Misaka0x2730/RubyLink/README.md

# RubyLink
Hardware platform for Miyako-Link based on RP2040

Firmware: https://github.com/Misaka0x2730/Miyako-Link
