Misaka0x2730/RubyLink/revB/RubyLink_revB.kicad_pcb

## KiCad design revB/RubyLink_revB.kicad_pcb (2022-08-15)

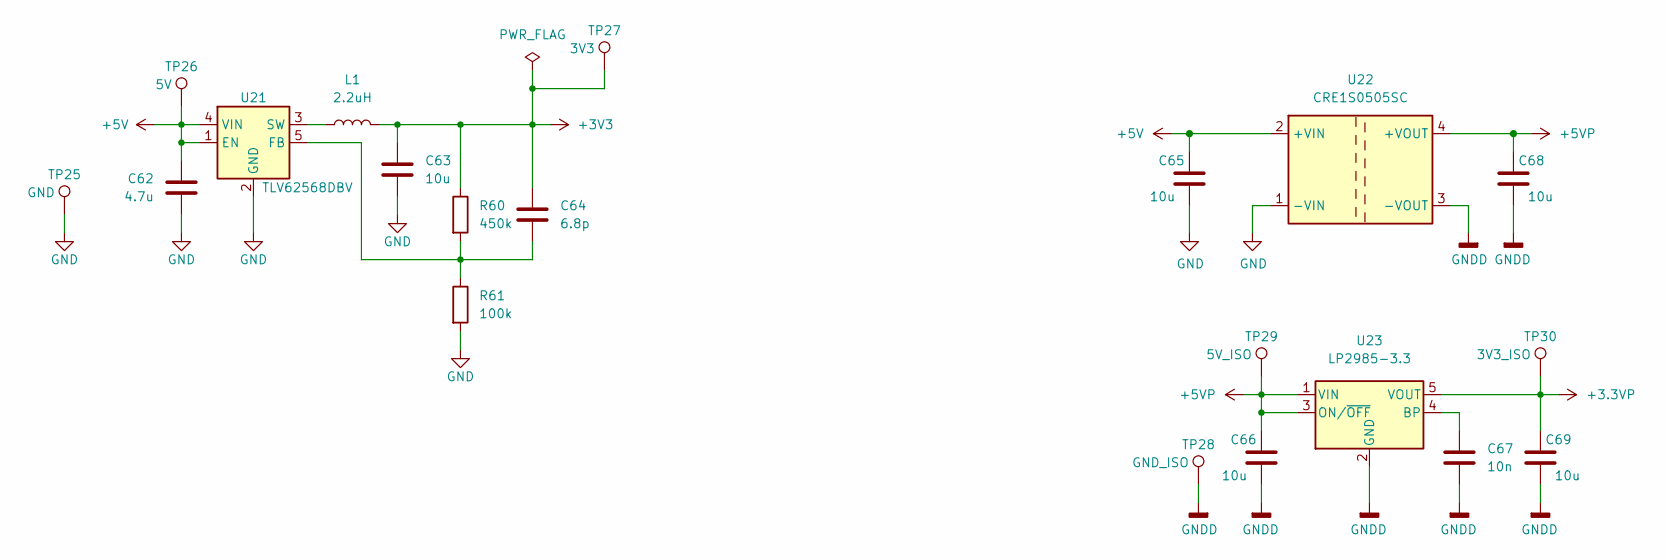
[picture p1: schematic Power.kicad_sch]

Parts:
C62: 4.7u; C_0603_1608Metric
C63: 10u; C_0603_1608Metric
C64: 6.8p; C_0402_1005Metric
C65, C66, C68, C69: 10u; C_0603_1608Metric; Part Number CC0603KRX5R6BB106
C67: 10n; C_0402_1005Metric
L1: 2.2uH; L_Taiyo-Yuden_NR-30xx; Part number NR3012T2R2M
R60: 450k; R_0402_1005Metric
R61: 100k; R_0402_1005Metric
TP25: GND; TestPoint_Pad_D1.0mm
TP26: 5V; TestPoint_Pad_D1.0mm
TP27: 3V3; TestPoint_Pad_D1.0mm
TP28: GND_ISO; TestPoint_Pad_D1.0mm
TP29: 5V_ISO; TestPoint_Pad_D1.0mm
TP30: 3V3_ISO; TestPoint_Pad_D1.0mm
U21: TLV62568DBV; SOT-23-5
U22: CRE1S0505SC; Converter_DCDC_Murata_CRE1xxxxxxSC_THT
U23: LP2985-3.3; SOT-23-5

Connections:
+3.3VP: C69.1, TP30.1, U23.5 (VOUT); also elsewhere on the board
+3V3: C63.1, C64.1, L1.2, R60.1, TP27.1; also elsewhere on the board
+5V: C62.2, C65.1, TP26.1, U21.1 (EN), U21.4 (VIN), U22.2 (+VIN); also elsewhere on the board
+5VP: C66.1, C68.1, TP29.1, U22.4 (+VOUT), U23.1 (VIN), U23.3 (ON/~OFF); also elsewhere on the board
GND: C62.1, C63.2, C65.2, R61.2, TP25.1, U21.2 (GND), U22.1 (-VIN); also elsewhere on the board
GNDD: C66.2, C67.2, C68.2, C69.2, TP28.1, U22.3 (-VOUT), U23.2 (GND); also elsewhere on the board
unnamed: C64.2, R60.2, R61.1, U21.5 (FB)
unnamed: C67.1, U23.4 (BP)
unnamed: L1.1, U21.3 (SW)

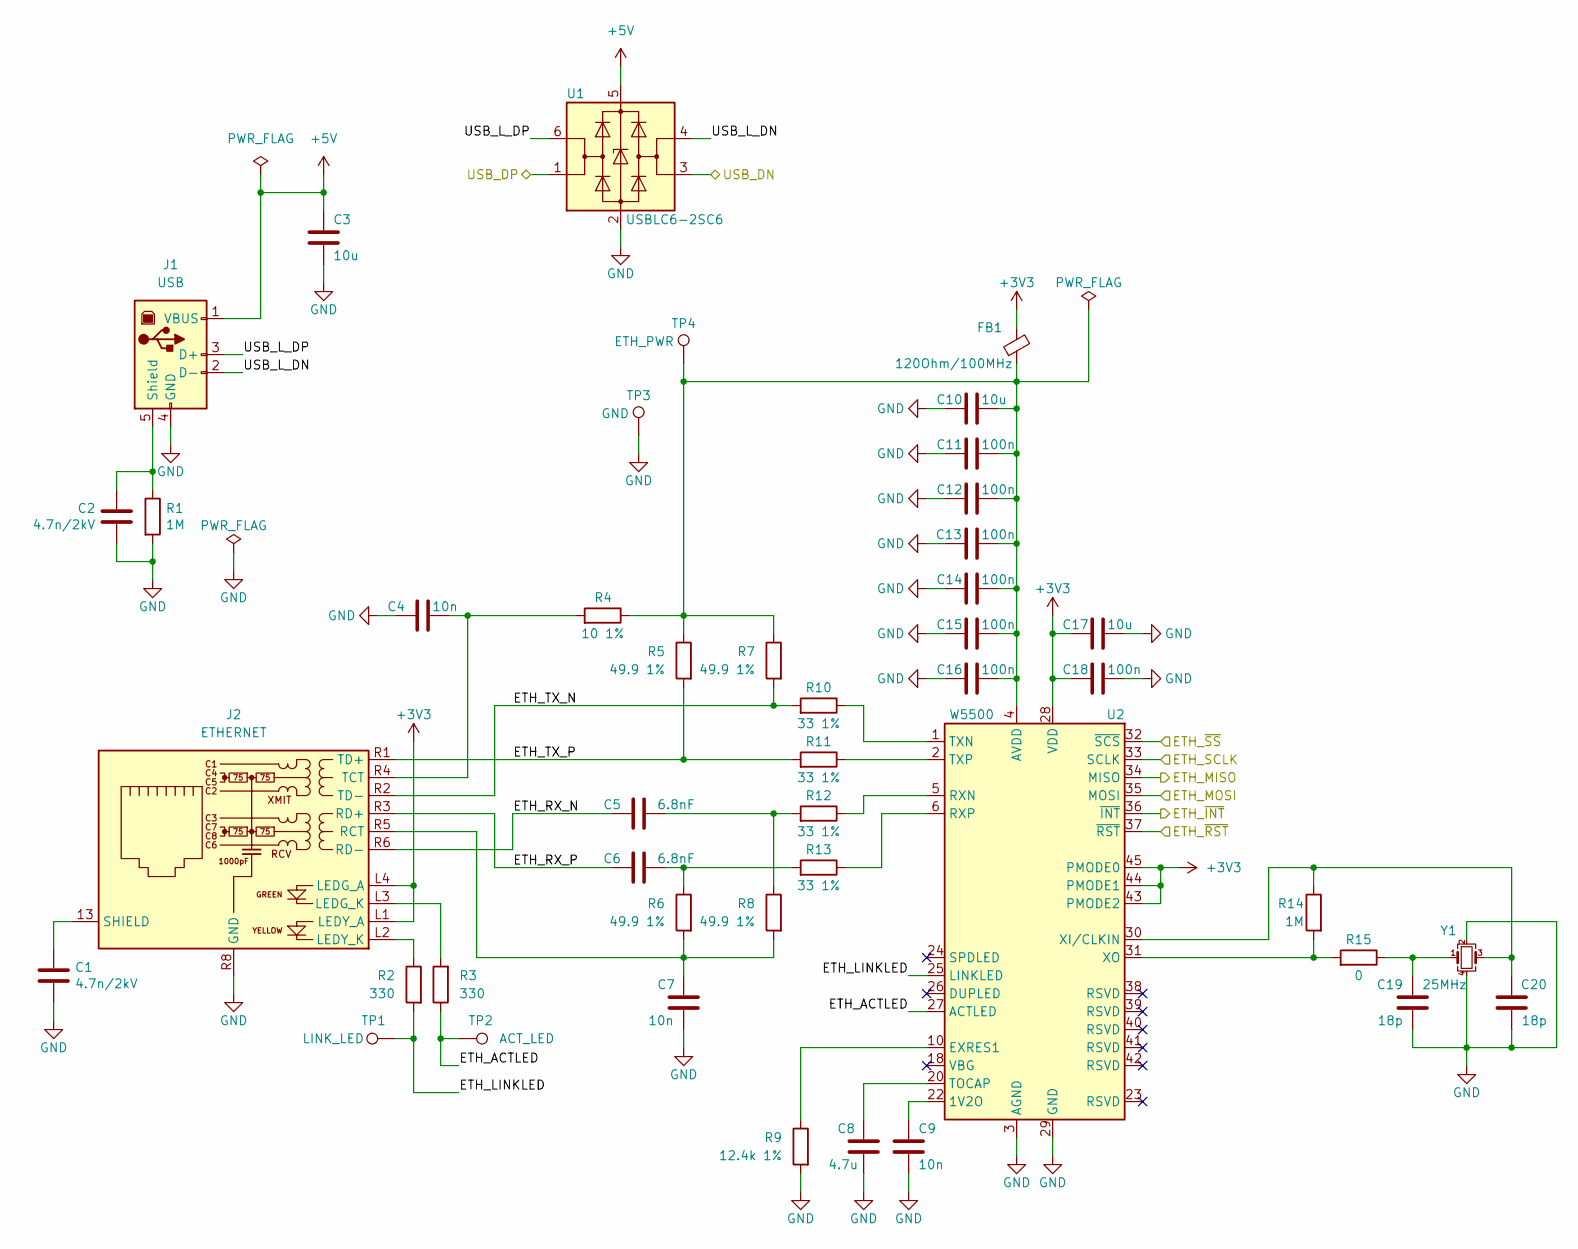
[picture p2: schematic Input_interfaces.kicad_sch]

Parts:
C1, C2: 4.7n/2kV; C_1812_4532Metric; Part Number 202S43W472KV4E
C3, C10, C17: 10u; C_0603_1608Metric
C4, C7, C9: 10n; C_0402_1005Metric
C5, C6: 6.8nF; C_0402_1005Metric
C8: 4.7u; C_0603_1608Metric
C11, C12, C13, C14, C15, C16, C18: 100n; C_0402_1005Metric
C19, C20: 18p; C_0402_1005Metric
FB1: 120Ohm/100MHz; L_0805_2012Metric
J1: USB; TE_292304-2
J2: ETHERNET; RJ45_Amphenol_RJMG1BD3B8K1ANR
R1: 1M; R_1206_3216Metric; Part Number 1206W4J0105T5E
R2, R3: 330; R_0402_1005Metric
R4: 10 1%; R_0603_1608Metric
R5, R6, R7, R8: 49.9 1%; R_0603_1608Metric
R9: 12.4k 1%; R_0402_1005Metric
R10, R11, R12, R13: 33 1%; R_0603_1608Metric
R14: 1M; R_0402_1005Metric
R15: 0; R_0402_1005Metric
TP1: LINK_LED; TestPoint_Pad_D1.0mm
TP2: ACT_LED; TestPoint_Pad_D1.0mm
TP3: GND; TestPoint_Pad_D1.0mm
TP4: ETH_PWR; TestPoint_Pad_D1.0mm
U1: USBLC6-2SC6; SOT-23-6
U2: W5500; LQFP-48_7x7mm_P0.5mm
Y1: 25MHz; Crystal_SMD_3225-4Pin_3.2x2.5mm

Connections:
+3V3: C17.1, C18.1, FB1.1, J2.L1 (LEDY_A), J2.L4 (LEDG_A), U2.28 (VDD), U2.43 (PMODE2), U2.44 (PMODE1), U2.45 (PMODE0); also elsewhere on the board
+5V: C3.1, J1.1 (VBUS), U1.5 (VBUS); also elsewhere on the board
/Input interfaces/ETH_ACTLED: R3.1, TP2.1, U2.27 (ACTLED)
/Input interfaces/ETH_LINKLED: R2.2, TP1.1, U2.25 (LINKLED)
/Input interfaces/ETH_MISO: U2.34 (MISO); also elsewhere on the board
/Input interfaces/ETH_MOSI: U2.35 (MOSI); also elsewhere on the board
/Input interfaces/ETH_RX_N: C5.1, J2.R6 (RD-)
/Input interfaces/ETH_RX_P: C6.1, J2.R3 (RD+)
/Input interfaces/ETH_SCLK: U2.33 (SCLK); also elsewhere on the board
/Input interfaces/ETH_TX_N: J2.R2 (TD-), R7.2, R10.2
/Input interfaces/ETH_TX_P: J2.R1 (TD+), R5.2, R11.2
/Input interfaces/ETH_~INT: U2.36 (~INT); also elsewhere on the board
/Input interfaces/ETH_~RST: U2.37 (~RST); also elsewhere on the board
/Input interfaces/ETH_~SS: U2.32 (~SCS); also elsewhere on the board
/Input interfaces/USB_DN: U1.3 (I/O2); also elsewhere on the board
/Input interfaces/USB_DP: U1.1 (I/O1); also elsewhere on the board
/Input interfaces/USB_L_DN: J1.2 (D-), U1.4 (I/O2)
/Input interfaces/USB_L_DP: J1.3 (D+), U1.6 (I/O1)
GND: C1.1, C2.1, C3.2, C4.1, C7.2, C8.2, C9.2, C10.1, C11.1, C12.1, C13.1, C14.1, C15.1, C16.1, C17.2, C18.2, C19.2, C20.2, J1.4 (GND), J2.R8 (GND), R1.2, R9.2, TP3.1, U1.2 (GND), U2.3 (AGND), U2.9 (AGND), U2.14 (AGND), U2.16 (AGND), U2.19 (AGND), U2.29 (GND), U2.48 (AGND), Y1.2, Y1.4; also elsewhere on the board
unnamed: C1.2, J2.13 (SHIELD)
unnamed: C2.2, J1.5 (Shield), R1.1
unnamed: C4.2, J2.R4 (TCT), R4.2
unnamed: C5.2, R8.1, R12.2
unnamed: C6.2, R6.1, R13.2
unnamed: C7.1, J2.R5 (RCT), R6.2, R8.2
unnamed: C8.1, U2.20 (TOCAP)
unnamed: C9.1, U2.22 (1V2O)
unnamed: C10.2, C11.2, C12.2, C13.2, C14.2, C15.2, C16.2, FB1.2, R4.1, R5.1, R7.1, TP4.1, U2.4 (AVDD), U2.8 (AVDD), U2.11 (AVDD), U2.15 (AVDD), U2.17 (AVDD), U2.21 (AVDD)
unnamed: C19.1, R15.1, Y1.1
unnamed: C20.1, R14.1, U2.30 (XI/CLKIN), Y1.3
unnamed: J2.L2 (LEDY_K), R2.1
unnamed: J2.L3 (LEDG_K), R3.2
unnamed: R9.1, U2.10 (EXRES1)
unnamed: R10.1, U2.1 (TXN)
unnamed: R11.1, U2.2 (TXP)
unnamed: R12.1, U2.5 (RXN)
unnamed: R13.1, U2.6 (RXP)
unnamed: R14.2, R15.2, U2.31 (XO)

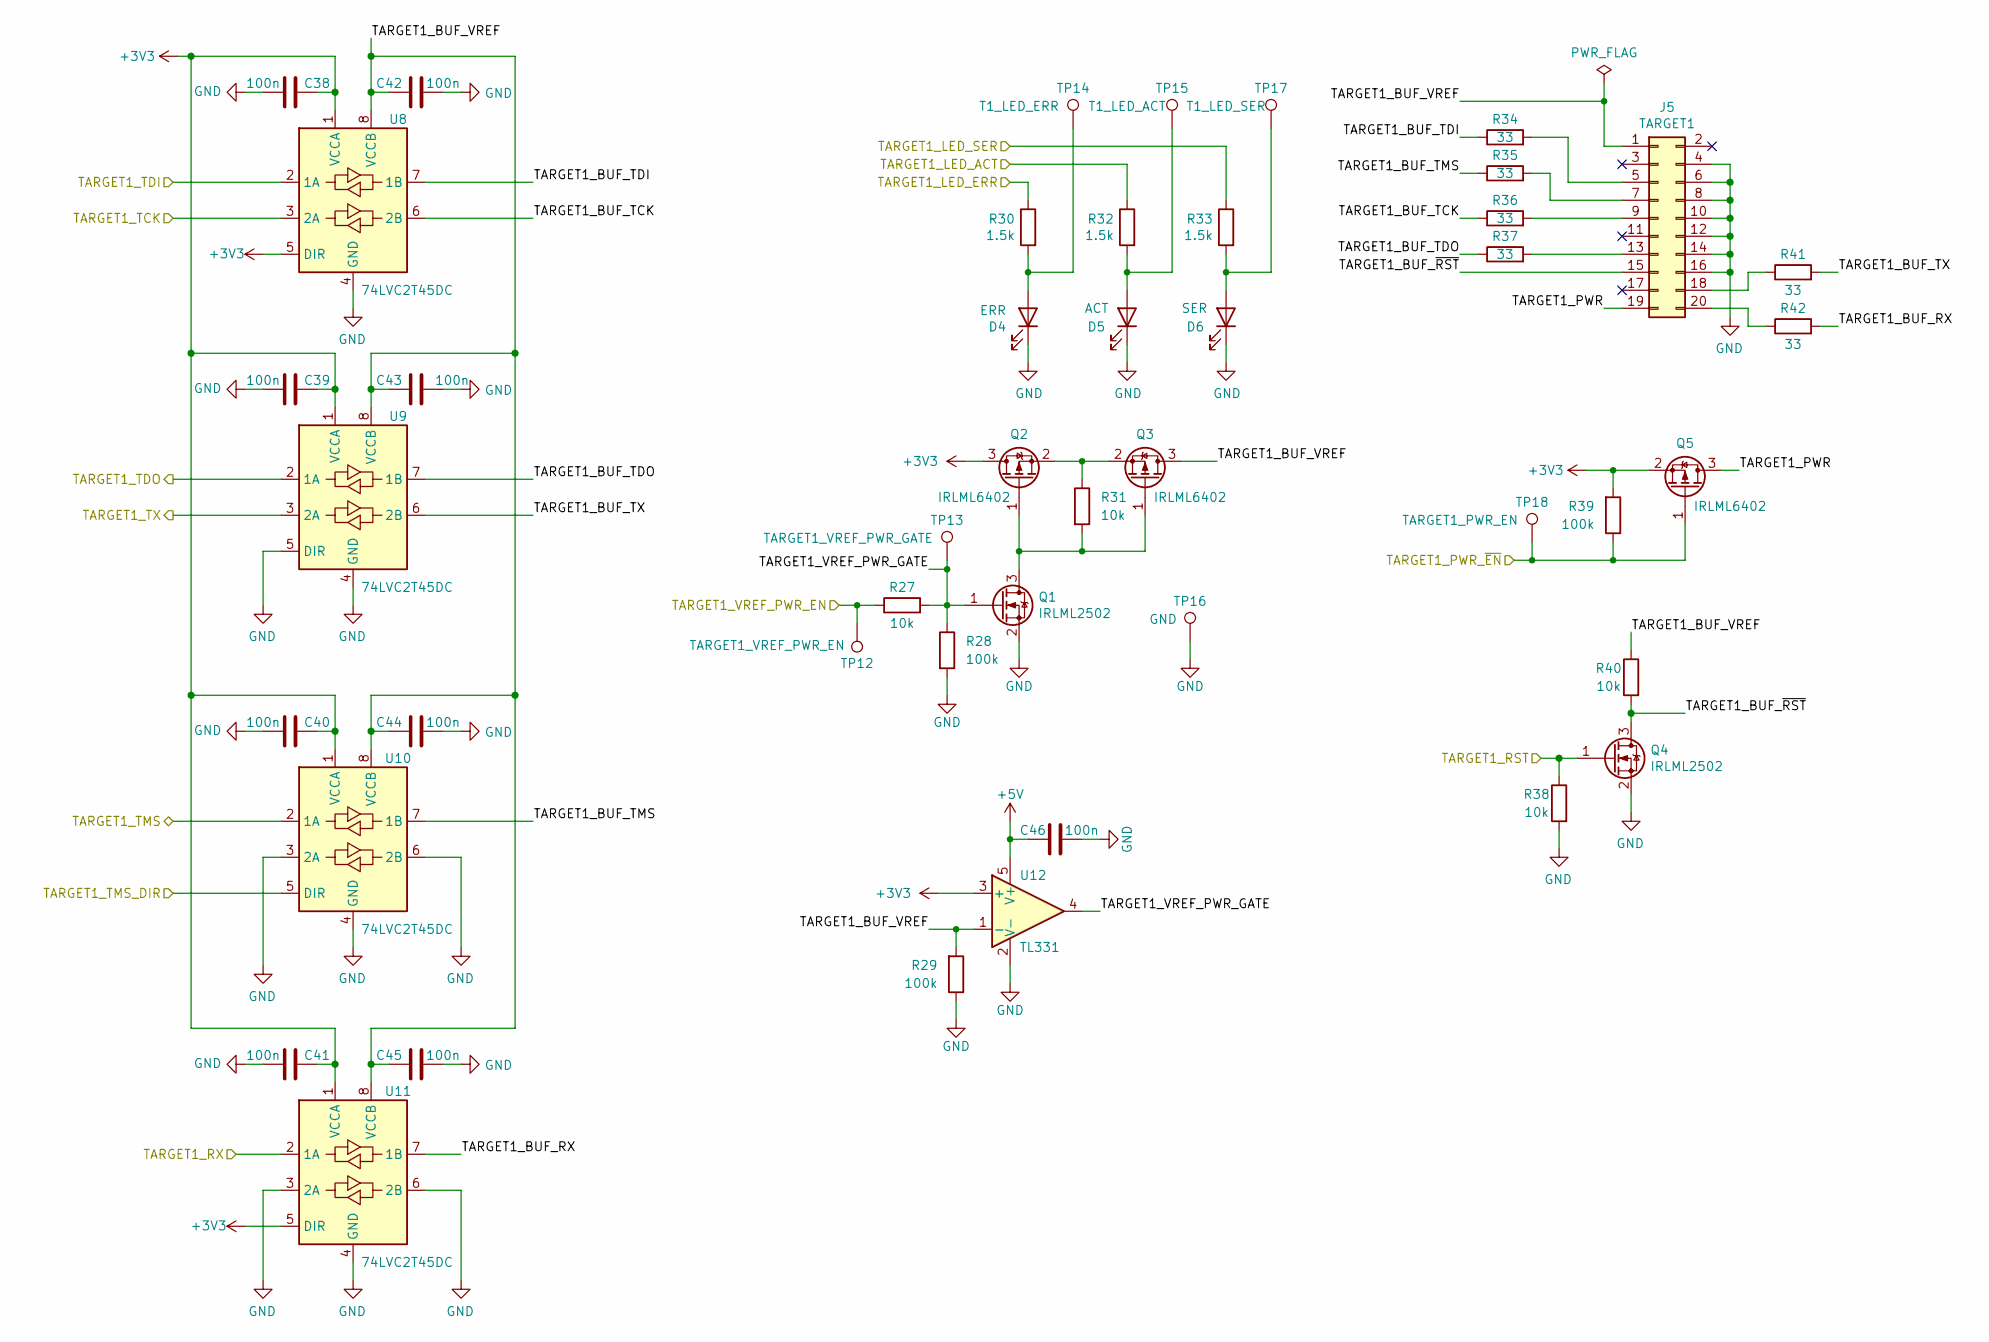
[picture p3: schematic Target1.kicad_sch]

Parts:
C38, C39, C40, C41, C42, C43, C44, C45: 100n; C_0402_1005Metric; Part Number CC0402KRX7R7BB104
C46: 100n; C_0402_1005Metric
D4: ERR; LED_D3.0mm
D5: ACT; LED_D3.0mm
D6: SER; LED_D3.0mm; Part Number FYLS-0603UYC
J5: TARGET1; IDC-Header_2x10_P2.54mm_Horizontal; Part Number BH-20R
Q1, Q4: IRLML2502; SOT-23; Part Number IRLML2502TRPBF
Q2, Q3, Q5: IRLML6402; SOT-23
R27, R31: 10k; R_0402_1005Metric
R28, R29, R39: 100k; R_0402_1005Metric
R30, R32, R33: 1.5k; R_0402_1005Metric; Part Number RC0402FR-071K5L
R34, R35, R36, R37, R41, R42: 33; R_0402_1005Metric; Part Number RC0402FR-07100KL
R38, R40: 10k; R_0402_1005Metric; Part Number RC0402FR-0710KL
TP12: TARGET1_VREF_PWR_EN; TestPoint_Pad_D1.0mm
TP13: TARGET1_VREF_PWR_GATE; TestPoint_Pad_D1.0mm
TP14: T1_LED_ERR; TestPoint_Pad_D1.0mm
TP15: T1_LED_ACT; TestPoint_Pad_D1.0mm
TP16: GND; TestPoint_Pad_D1.0mm
TP17: T1_LED_SER; TestPoint_Pad_D1.0mm
TP18: TARGET1_PWR_EN; TestPoint_Pad_D1.0mm
U8, U9, U10, U11: 74LVC2T45DC; VSSOP-8_2.3x2mm_P0.5mm; Part Number SN74LVC2T45DCUR
U12: TL331; SOT-23-5

Connections:
+3V3: C38.1, C39.1, C40.1, C41.1, Q2.3 (D), Q5.2 (S), R39.2, U8.1 (VCCA), U8.5 (DIR), U9.1 (VCCA), U10.1 (VCCA), U11.1 (VCCA), U11.5 (DIR), U12.3 (+); also elsewhere on the board
+5V: C46.1, U12.5 (V+); also elsewhere on the board
/MCU/TARGET1_LED_ACT: R32.1; also elsewhere on the board
/MCU/TARGET1_LED_ERR: R30.1; also elsewhere on the board
/MCU/TARGET1_LED_SER: R33.1; also elsewhere on the board
/MCU/TARGET1_PWR_~EN: Q5.1 (G), R39.1, TP18.1; also elsewhere on the board
/MCU/TARGET1_RST: Q4.1 (G), R38.1; also elsewhere on the board
/MCU/TARGET1_RX: U9.3 (2A); also elsewhere on the board
/MCU/TARGET1_TCK: U8.3 (2A); also elsewhere on the board
/MCU/TARGET1_TDI: U8.2 (1A); also elsewhere on the board
/MCU/TARGET1_TDO: U9.2 (1A); also elsewhere on the board
/MCU/TARGET1_TMS: U10.2 (1A); also elsewhere on the board
/MCU/TARGET1_TMS_DIR: U10.5 (DIR); also elsewhere on the board
/MCU/TARGET1_TX: U11.2 (1A); also elsewhere on the board
/MCU/TARGET1_VREF_PWR_EN: R27.1, TP12.1; also elsewhere on the board
/Target1/TARGET1_BUF_RX: R42.2, U11.7 (1B)
/Target1/TARGET1_BUF_TCK: R36.1, U8.6 (2B)
/Target1/TARGET1_BUF_TDI: R34.1, U8.7 (1B)
/Target1/TARGET1_BUF_TDO: R37.1, U9.7 (1B)
/Target1/TARGET1_BUF_TMS: R35.1, U10.7 (1B)
/Target1/TARGET1_BUF_TX: R41.2, U9.6 (2B)
/Target1/TARGET1_BUF_VREF: C42.2, C43.2, C44.2, C45.2, J5.1, Q3.3 (D), R29.2, R40.1, U8.8 (VCCB), U9.8 (VCCB), U10.8 (VCCB), U11.8 (VCCB), U12.1 (-)
/Target1/TARGET1_BUF_~RST: J5.15, Q4.3 (D), R40.2
/Target1/TARGET1_PWR: J5.19, Q5.3 (D)
/Target1/TARGET1_VREF_PWR_GATE: Q1.1 (G), R27.2, R28.1, TP13.1, U12.4
GND: C38.2, C39.2, C40.2, C41.2, C42.1, C43.1, C44.1, C45.1, C46.2, D4.1 (K), D5.1 (K), D6.1 (K), J5.4, J5.6, J5.8, J5.10, J5.12, J5.14, J5.16, Q1.2 (S), Q4.2 (S), R28.2, R29.1, R38.2, TP16.1, U8.4 (GND), U9.4 (GND), U9.5 (DIR), U10.3 (2A), U10.4 (GND), U10.6 (2B), U11.3 (2A), U11.4 (GND), U11.6 (2B), U12.2 (V-); also elsewhere on the board
unnamed: D4.2 (A), R30.2, TP14.1
unnamed: D5.2 (A), R32.2, TP15.1
unnamed: D6.2 (A), R33.2, TP17.1
unnamed: J5.5, R34.2
unnamed: J5.7, R35.2
unnamed: J5.9, R36.2
unnamed: J5.13, R37.2
unnamed: J5.18, R41.1
unnamed: J5.20, R42.1
unnamed: Q1.3 (D), Q2.1 (G), Q3.1 (G), R31.2
unnamed: Q2.2 (S), Q3.2 (S), R31.1

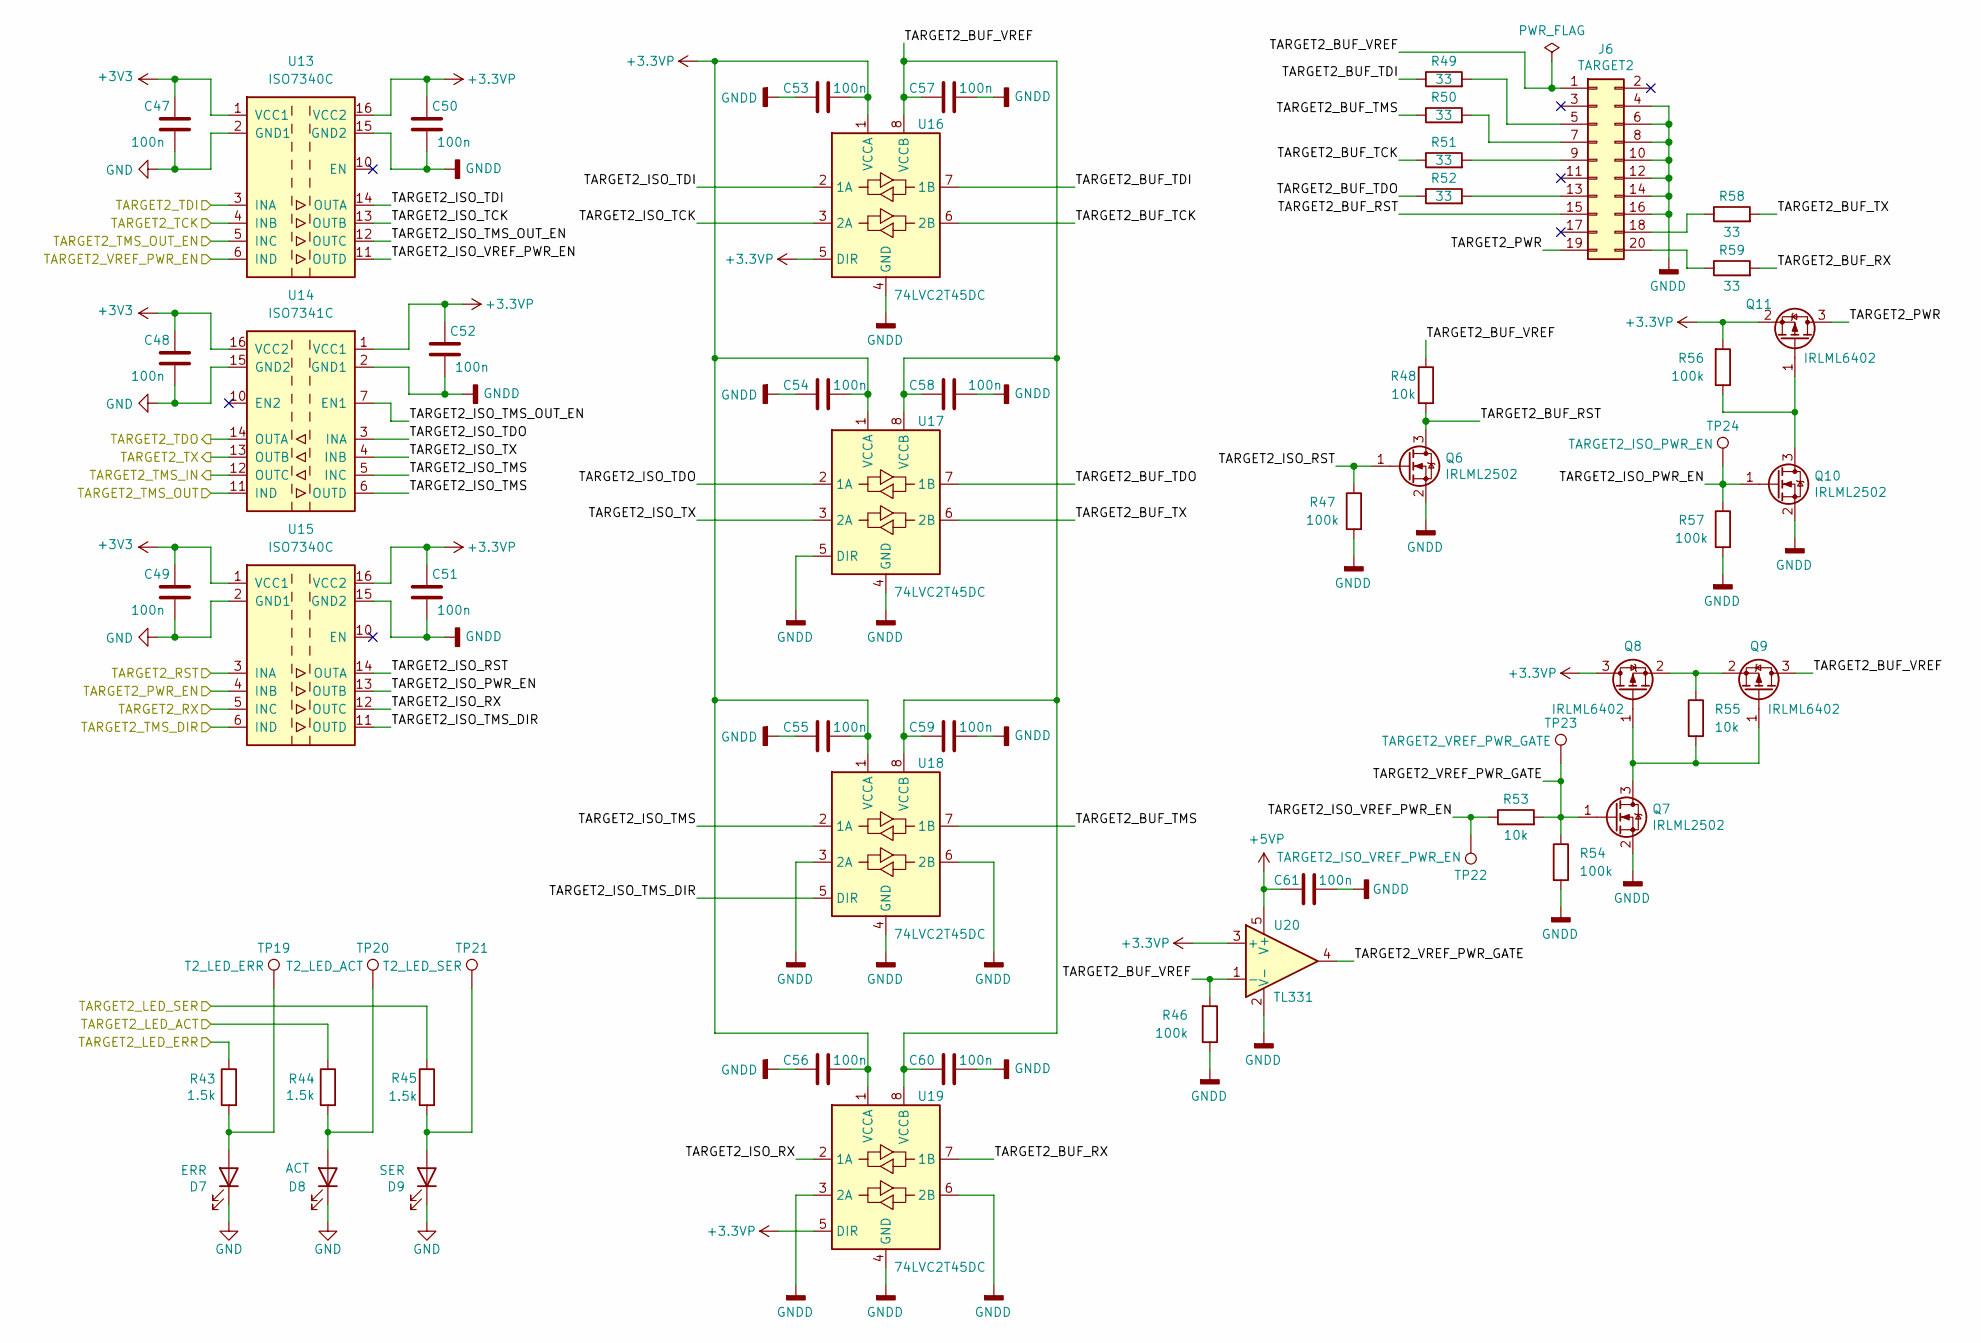
[picture p4: schematic Target2_Iso.kicad_sch]

Parts:
C47, C48, C49, C50, C51, C52, C53, C54, C55, C56, C57, C58, C59, C60: 100n; C_0402_1005Metric; Part Number CC0402KRX7R7BB104
C61: 100n; C_0402_1005Metric
D7: ERR; LED_D3.0mm
D8: ACT; LED_D3.0mm
D9: SER; LED_D3.0mm; Part Number FYLS-0603UYC
J6: TARGET2; IDC-Header_2x10_P2.54mm_Horizontal; Part Number BH-20R
Q6, Q7, Q10: IRLML2502; SOT-23; Part Number IRLML2502TRPBF
Q8, Q9, Q11: IRLML6402; SOT-23
R43, R44, R45: 1.5k; R_0402_1005Metric; Part Number RC0402FR-071K5L
R46, R54, R56: 100k; R_0402_1005Metric
R47, R57: 100k; R_0402_1005Metric; Part Number RC0402FR-0710KL
R48: 10k; R_0402_1005Metric; Part Number RC0402FR-0710KL
R49, R50, R51, R52, R58, R59: 33; R_0402_1005Metric; Part Number RC0402FR-07100KL
R53, R55: 10k; R_0402_1005Metric
TP19: T2_LED_ERR; TestPoint_Pad_D1.0mm
TP20: T2_LED_ACT; TestPoint_Pad_D1.0mm
TP21: T2_LED_SER; TestPoint_Pad_D1.0mm
TP22: TARGET2_ISO_VREF_PWR_EN; TestPoint_Pad_D1.0mm
TP23: TARGET2_VREF_PWR_GATE; TestPoint_Pad_D1.0mm
TP24: TARGET2_ISO_PWR_EN; TestPoint_Pad_D1.0mm
U13, U15: ISO7340C; SOIC-16W_7.5x10.3mm_P1.27mm
U14: ISO7341C; SOIC-16W_7.5x10.3mm_P1.27mm
U16, U17, U18, U19: 74LVC2T45DC; VSSOP-8_2.3x2mm_P0.5mm; Part Number SN74LVC2T45DCUR
U20: TL331; SOT-23-5

Connections:
+3.3VP: C50.2, C51.2, C52.2, C53.2, C54.2, C55.2, C56.2, Q8.3 (D), Q11.2 (S), R56.2, U13.16 (VCC2), U14.1 (VCC1), U15.16 (VCC2), U16.1 (VCCA), U16.5 (DIR), U17.1 (VCCA), U18.1 (VCCA), U19.1 (VCCA), U19.5 (DIR), U20.3 (+); also elsewhere on the board
+3V3: C47.2, C48.2, C49.2, U13.1 (VCC1), U14.16 (VCC2), U15.1 (VCC1); also elsewhere on the board
+5VP: C61.1, U20.5 (V+); also elsewhere on the board
/MCU/TARGET2_LED_ACT: R44.1; also elsewhere on the board
/MCU/TARGET2_LED_ERR: R43.1; also elsewhere on the board
/MCU/TARGET2_LED_SER: R45.1; also elsewhere on the board
/MCU/TARGET2_PWR_EN: U15.4 (INB); also elsewhere on the board
/MCU/TARGET2_RST: U15.3 (INA); also elsewhere on the board
/MCU/TARGET2_RX: U14.13 (OUTB); also elsewhere on the board
/MCU/TARGET2_TCK: U13.4 (INB); also elsewhere on the board
/MCU/TARGET2_TDI: U13.3 (INA); also elsewhere on the board
/MCU/TARGET2_TDO: U14.14 (OUTA); also elsewhere on the board
/MCU/TARGET2_TMS_DIR: U15.6 (IND); also elsewhere on the board
/MCU/TARGET2_TMS_IN: U14.12 (OUTC); also elsewhere on the board
/MCU/TARGET2_TMS_OUT: U14.11 (IND); also elsewhere on the board
/MCU/TARGET2_TMS_OUT_EN: U13.5 (INC); also elsewhere on the board
/MCU/TARGET2_TX: U15.5 (INC); also elsewhere on the board
/MCU/TARGET2_VREF_PWR_EN: U13.6 (IND); also elsewhere on the board
/Target2_Iso/TARGET2_BUF_RST: J6.15, Q6.3 (D), R48.2
/Target2_Iso/TARGET2_BUF_RX: R59.2, U19.7 (1B)
/Target2_Iso/TARGET2_BUF_TCK: R51.1, U16.6 (2B)
/Target2_Iso/TARGET2_BUF_TDI: R49.1, U16.7 (1B)
/Target2_Iso/TARGET2_BUF_TDO: R52.1, U17.7 (1B)
/Target2_Iso/TARGET2_BUF_TMS: R50.1, U18.7 (1B)
/Target2_Iso/TARGET2_BUF_TX: R58.2, U17.6 (2B)
/Target2_Iso/TARGET2_BUF_VREF: C57.2, C58.2, C59.2, C60.2, J6.1, Q9.3 (D), R46.2, R48.1, U16.8 (VCCB), U17.8 (VCCB), U18.8 (VCCB), U19.8 (VCCB), U20.1 (-)
/Target2_Iso/TARGET2_ISO_PWR_EN: Q10.1 (G), R57.1, TP24.1, U15.13 (OUTB)
/Target2_Iso/TARGET2_ISO_RST: Q6.1 (G), R47.1, U15.14 (OUTA)
/Target2_Iso/TARGET2_ISO_RX: U15.12 (OUTC), U19.2 (1A)
/Target2_Iso/TARGET2_ISO_TCK: U13.13 (OUTB), U16.3 (2A)
/Target2_Iso/TARGET2_ISO_TDI: U13.14 (OUTA), U16.2 (1A)
/Target2_Iso/TARGET2_ISO_TDO: U14.3 (INA), U17.2 (1A)
/Target2_Iso/TARGET2_ISO_TMS: U14.5 (INC), U14.6 (OUTD), U18.2 (1A)
/Target2_Iso/TARGET2_ISO_TMS_DIR: U15.11 (OUTD), U18.5 (DIR)
/Target2_Iso/TARGET2_ISO_TMS_OUT_EN: U13.12 (OUTC), U14.7 (EN1)
/Target2_Iso/TARGET2_ISO_TX: U14.4 (INB), U17.3 (2A)
/Target2_Iso/TARGET2_ISO_VREF_PWR_EN: R53.1, TP22.1, U13.11 (OUTD)
/Target2_Iso/TARGET2_PWR: J6.19, Q11.3 (D)
/Target2_Iso/TARGET2_VREF_PWR_GATE: Q7.1 (G), R53.2, R54.1, TP23.1, U20.4
GND: C47.1, C48.1, C49.1, D7.1 (K), D8.1 (K), D9.1 (K), U13.2 (GND1), U13.8 (GND1), U14.9 (GND2), U14.15 (GND2), U15.2 (GND1), U15.8 (GND1); also elsewhere on the board
GNDD: C50.1, C51.1, C52.1, C53.1, C54.1, C55.1, C56.1, C57.1, C58.1, C59.1, C60.1, C61.2, J6.4, J6.6, J6.8, J6.10, J6.12, J6.14, J6.16, Q6.2 (S), Q7.2 (S), Q10.2 (S), R46.1, R47.2, R54.2, R57.2, U13.9 (GND2), U13.15 (GND2), U14.2 (GND1), U14.8 (GND1), U15.9 (GND2), U15.15 (GND2), U16.4 (GND), U17.4 (GND), U17.5 (DIR), U18.3 (2A), U18.4 (GND), U18.6 (2B), U19.3 (2A), U19.4 (GND), U19.6 (2B), U20.2 (V-); also elsewhere on the board
unnamed: D7.2 (A), R43.2, TP19.1
unnamed: D8.2 (A), R44.2, TP20.1
unnamed: D9.2 (A), R45.2, TP21.1
unnamed: J6.5, R49.2
unnamed: J6.7, R50.2
unnamed: J6.9, R51.2
unnamed: J6.13, R52.2
unnamed: J6.18, R58.1
unnamed: J6.20, R59.1
unnamed: Q7.3 (D), Q8.1 (G), Q9.1 (G), R55.2
unnamed: Q8.2 (S), Q9.2 (S), R55.1
unnamed: Q10.3 (D), Q11.1 (G), R56.1

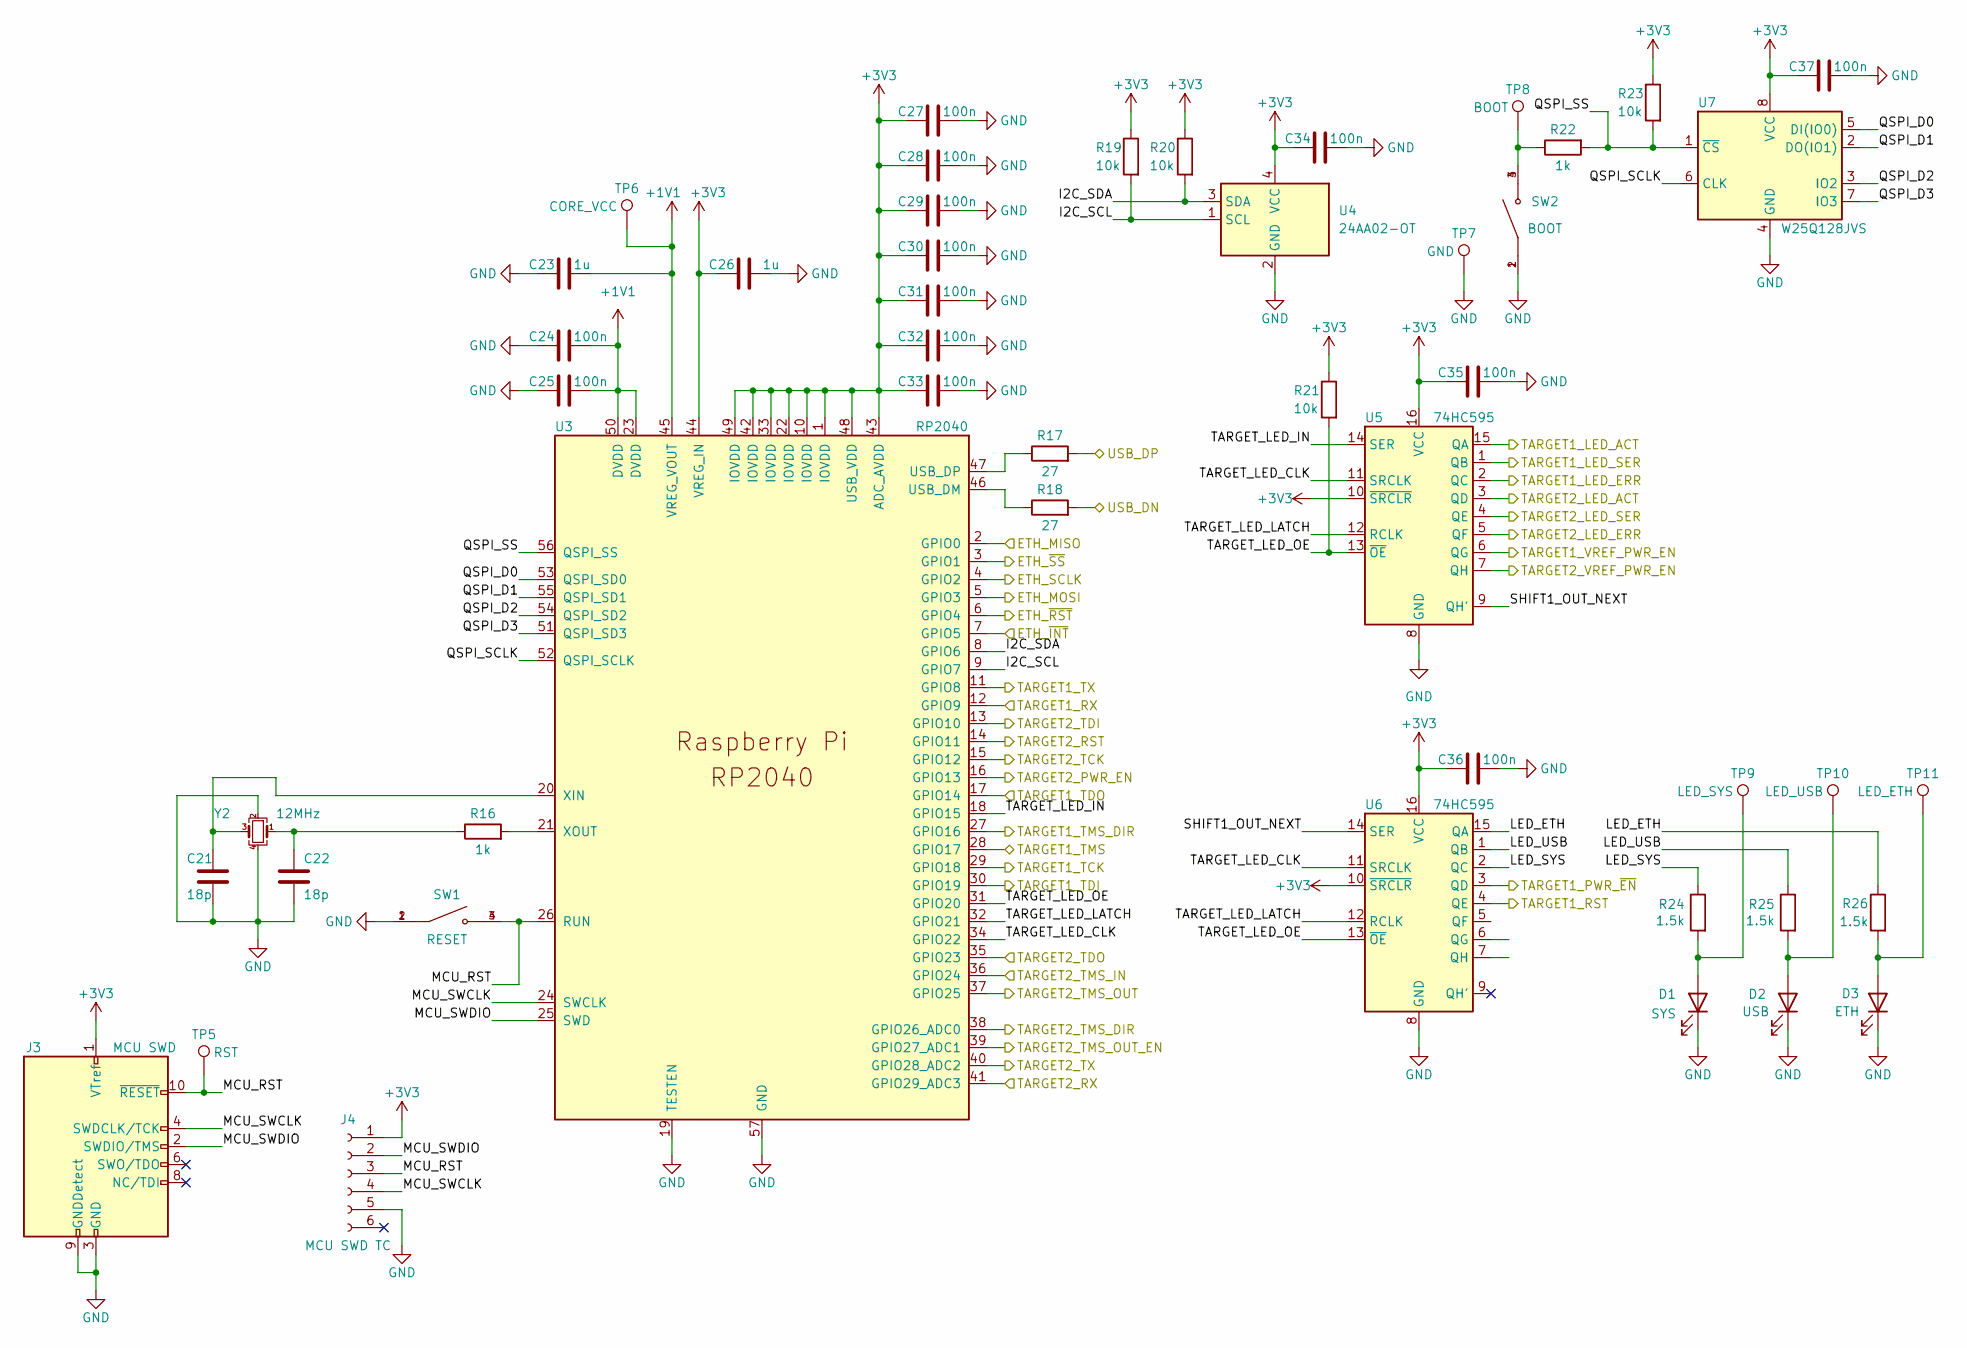
[picture p5: schematic MCU.kicad_sch]

Parts:
C21, C22: 18p; C_0402_1005Metric
C23, C26: 1u; C_0402_1005Metric
C24, C25, C27, C28, C29, C30, C31, C32, C33, C34, C35, C36, C37: 100n; C_0402_1005Metric
D1: SYS; LED_D3.0mm
D2: USB; LED_D3.0mm
D3: ETH; LED_D3.0mm; Part Number FYLS-0603UYC
J3: MCU SWD; IDC-Header_2x05_P2.54mm_Vertical
J4: MCU SWD TC; Tag-Connect_TC2030-IDC-FP_2x03_P1.27mm_Vertical
R16, R22: 1k; R_0402_1005Metric
R17, R18: 27; R_0402_1005Metric
R19, R20, R21, R23: 10k; R_0402_1005Metric
R24, R25, R26: 1.5k; R_0402_1005Metric; Part Number RC0402FR-071K5L
SW1: RESET; SW_1571563-9
SW2: BOOT; SW_1571563-9
TP5: RST; TestPoint_Pad_D1.0mm
TP6: CORE_VCC; TestPoint_Pad_D1.0mm
TP7: GND; TestPoint_Pad_D1.0mm
TP8: BOOT; TestPoint_Pad_D1.0mm
TP9: LED_SYS; TestPoint_Pad_D1.0mm
TP10: LED_USB; TestPoint_Pad_D1.0mm
TP11: LED_ETH; TestPoint_Pad_D1.0mm
U3: RP2040; RP2040-QFN-56
U4: 24AA02-OT; SOT-23-5
U5, U6: 74HC595; SOIC-16_3.9x9.9mm_P1.27mm
U7: W25Q128JVS; SOIC-8_5.23x5.23mm_P1.27mm
Y2: 12MHz; Crystal_SMD_3225-4Pin_3.2x2.5mm

Connections:
+1V1: C23.2, C24.2, C25.2, TP6.1, U3.23 (DVDD), U3.45 (VREG_VOUT), U3.50 (DVDD)
+3V3: C26.1, C27.1, C28.1, C29.1, C30.1, C31.1, C32.1, C33.1, C34.1, C35.1, C36.1, C37.1, J3.1 (VTref), J4.1, R19.1, R20.1, R21.1, R23.1, U3.1 (IOVDD), U3.10 (IOVDD), U3.22 (IOVDD), U3.33 (IOVDD), U3.42 (IOVDD), U3.43 (ADC_AVDD), U3.44 (VREG_IN), U3.48 (USB_VDD), U3.49 (IOVDD), U4.4 (VCC), U5.10 (~SRCLR), U5.16 (VCC), U6.10 (~SRCLR), U6.16 (VCC), U7.8 (VCC); also elsewhere on the board
/Input interfaces/ETH_MISO: U3.2 (GPIO0); also elsewhere on the board
/Input interfaces/ETH_MOSI: U3.5 (GPIO3); also elsewhere on the board
/Input interfaces/ETH_SCLK: U3.4 (GPIO2); also elsewhere on the board
/Input interfaces/ETH_~INT: U3.7 (GPIO5); also elsewhere on the board
/Input interfaces/ETH_~RST: U3.6 (GPIO4); also elsewhere on the board
/Input interfaces/ETH_~SS: U3.3 (GPIO1); also elsewhere on the board
/Input interfaces/USB_DN: R18.2; also elsewhere on the board
/Input interfaces/USB_DP: R17.2; also elsewhere on the board
/MCU/I2C_SCL: R19.2, U3.9 (GPIO7), U4.1 (SCL)
/MCU/I2C_SDA: R20.2, U3.8 (GPIO6), U4.3 (SDA)
/MCU/LED_ETH: R26.1, U6.15 (QA)
/MCU/LED_SYS: R24.1, U6.2 (QC)
/MCU/LED_USB: R25.1, U6.1 (QB)
/MCU/MCU_RST: J3.10 (~RESET), J4.3, SW1.3, SW1.4, TP5.1, U3.26 (RUN)
/MCU/MCU_SWCLK: J3.4 (SWDCLK/TCK), J4.4, U3.24 (SWCLK)
/MCU/MCU_SWDIO: J3.2 (SWDIO/TMS), J4.2, U3.25 (SWD)
/MCU/QSPI_D0: U3.53 (QSPI_SD0), U7.5 (DI(IO0))
/MCU/QSPI_D1: U3.55 (QSPI_SD1), U7.2 (DO(IO1))
/MCU/QSPI_D2: U3.54 (QSPI_SD2), U7.3 (IO2)
/MCU/QSPI_D3: U3.51 (QSPI_SD3), U7.7 (IO3)
/MCU/QSPI_SCLK: U3.52 (QSPI_SCLK), U7.6 (CLK)
/MCU/QSPI_SS: R22.2, R23.2, U3.56 (QSPI_SS), U7.1 (~CS)
/MCU/SHIFT1_OUT_NEXT: U5.9 (QH'), U6.14 (SER)
/MCU/TARGET1_LED_ACT: U5.15 (QA); also elsewhere on the board
/MCU/TARGET1_LED_ERR: U5.2 (QC); also elsewhere on the board
/MCU/TARGET1_LED_SER: U5.1 (QB); also elsewhere on the board
/MCU/TARGET1_PWR_~EN: U6.3 (QD); also elsewhere on the board
/MCU/TARGET1_RST: U6.4 (QE); also elsewhere on the board
/MCU/TARGET1_RX: U3.12 (GPIO9); also elsewhere on the board
/MCU/TARGET1_TCK: U3.29 (GPIO18); also elsewhere on the board
/MCU/TARGET1_TDI: U3.30 (GPIO19); also elsewhere on the board
/MCU/TARGET1_TDO: U3.17 (GPIO14); also elsewhere on the board
/MCU/TARGET1_TMS: U3.28 (GPIO17); also elsewhere on the board
/MCU/TARGET1_TMS_DIR: U3.27 (GPIO16); also elsewhere on the board
/MCU/TARGET1_TX: U3.11 (GPIO8); also elsewhere on the board
/MCU/TARGET1_VREF_PWR_EN: U5.6 (QG); also elsewhere on the board
/MCU/TARGET2_LED_ACT: U5.3 (QD); also elsewhere on the board
/MCU/TARGET2_LED_ERR: U5.5 (QF); also elsewhere on the board
/MCU/TARGET2_LED_SER: U5.4 (QE); also elsewhere on the board
/MCU/TARGET2_PWR_EN: U3.16 (GPIO13); also elsewhere on the board
/MCU/TARGET2_RST: U3.14 (GPIO11); also elsewhere on the board
/MCU/TARGET2_RX: U3.41 (GPIO29_ADC3); also elsewhere on the board
/MCU/TARGET2_TCK: U3.15 (GPIO12); also elsewhere on the board
/MCU/TARGET2_TDI: U3.13 (GPIO10); also elsewhere on the board
/MCU/TARGET2_TDO: U3.35 (GPIO23); also elsewhere on the board
/MCU/TARGET2_TMS_DIR: U3.38 (GPIO26_ADC0); also elsewhere on the board
/MCU/TARGET2_TMS_IN: U3.36 (GPIO24); also elsewhere on the board
/MCU/TARGET2_TMS_OUT: U3.37 (GPIO25); also elsewhere on the board
/MCU/TARGET2_TMS_OUT_EN: U3.39 (GPIO27_ADC1); also elsewhere on the board
/MCU/TARGET2_TX: U3.40 (GPIO28_ADC2); also elsewhere on the board
/MCU/TARGET2_VREF_PWR_EN: U5.7 (QH); also elsewhere on the board
/MCU/TARGET_LED_CLK: U3.34 (GPIO22), U5.11 (SRCLK), U6.11 (SRCLK)
/MCU/TARGET_LED_IN: U3.18 (GPIO15), U5.14 (SER)
/MCU/TARGET_LED_LATCH: U3.32 (GPIO21), U5.12 (RCLK), U6.12 (RCLK)
/MCU/TARGET_LED_OE: R21.2, U3.31 (GPIO20), U5.13 (~OE), U6.13 (~OE)
GND: C21.2, C22.2, C23.1, C24.1, C25.1, C26.2, C27.2, C28.2, C29.2, C30.2, C31.2, C32.2, C33.2, C34.2, C35.2, C36.2, C37.2, D1.1 (K), D2.1 (K), D3.1 (K), J3.3 (GND), J3.5 (GND), J3.9 (GNDDetect), J4.5, SW1.1, SW1.2, SW2.1, SW2.2, TP7.1, U3.19 (TESTEN), U3.57 (GND), U4.2 (GND), U5.8 (GND), U6.8 (GND), U7.4 (GND), Y2.2, Y2.4; also elsewhere on the board
unnamed: C21.1, U3.20 (XIN), Y2.3
unnamed: C22.1, R16.1, Y2.1
unnamed: D1.2 (A), R24.2, TP9.1
unnamed: D2.2 (A), R25.2, TP10.1
unnamed: D3.2 (A), R26.2, TP11.1
unnamed: R16.2, U3.21 (XOUT)
unnamed: R17.1, U3.47 (USB_DP)
unnamed: R18.1, U3.46 (USB_DM)
unnamed: R22.1, SW2.3, SW2.4, TP8.1
