Misaka0x2730/RubyLink/revB/RubyLink_revB.kicad_pcb

## KiCad design revB/RubyLink_revB.kicad_pcb (continued)

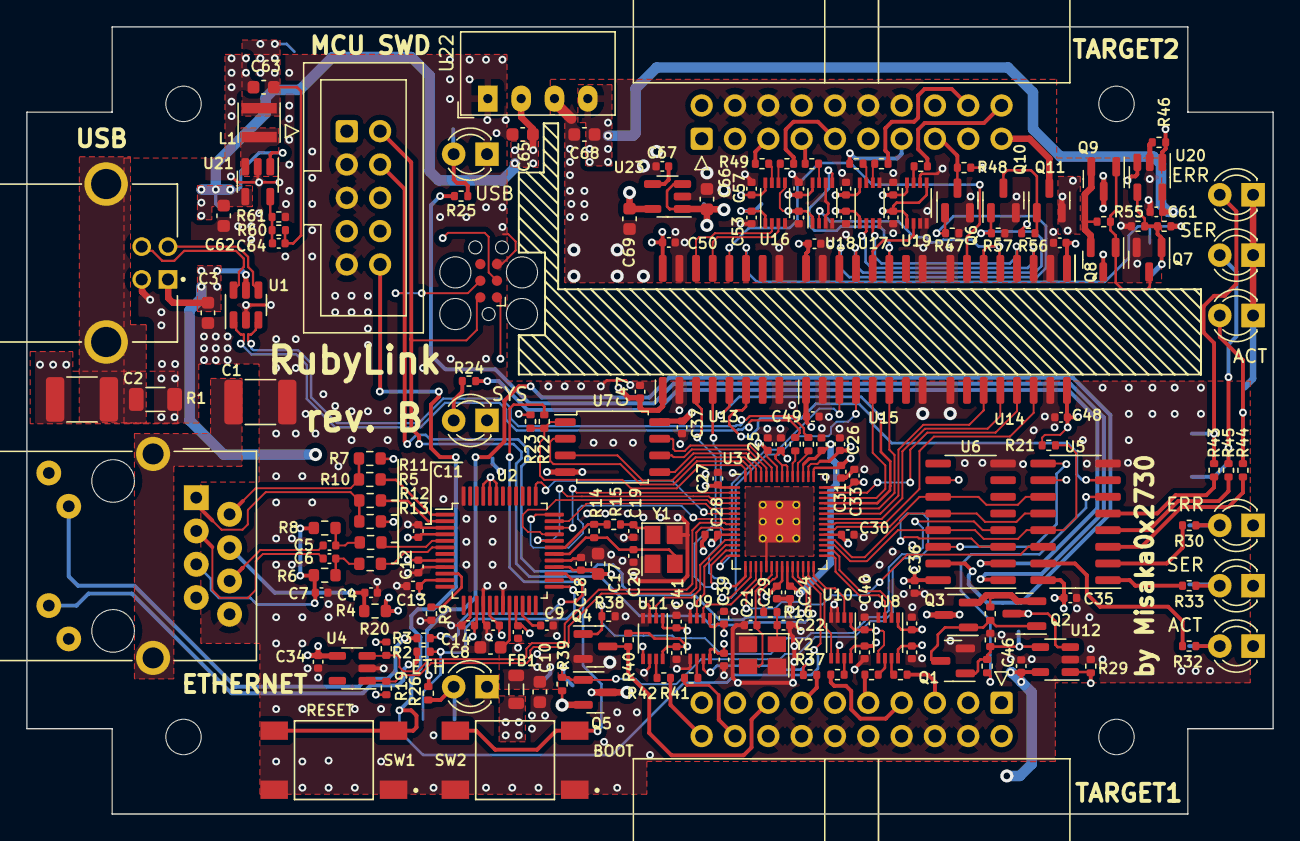
[picture p6: board RubyLink_revB.kicad_pcb from above]

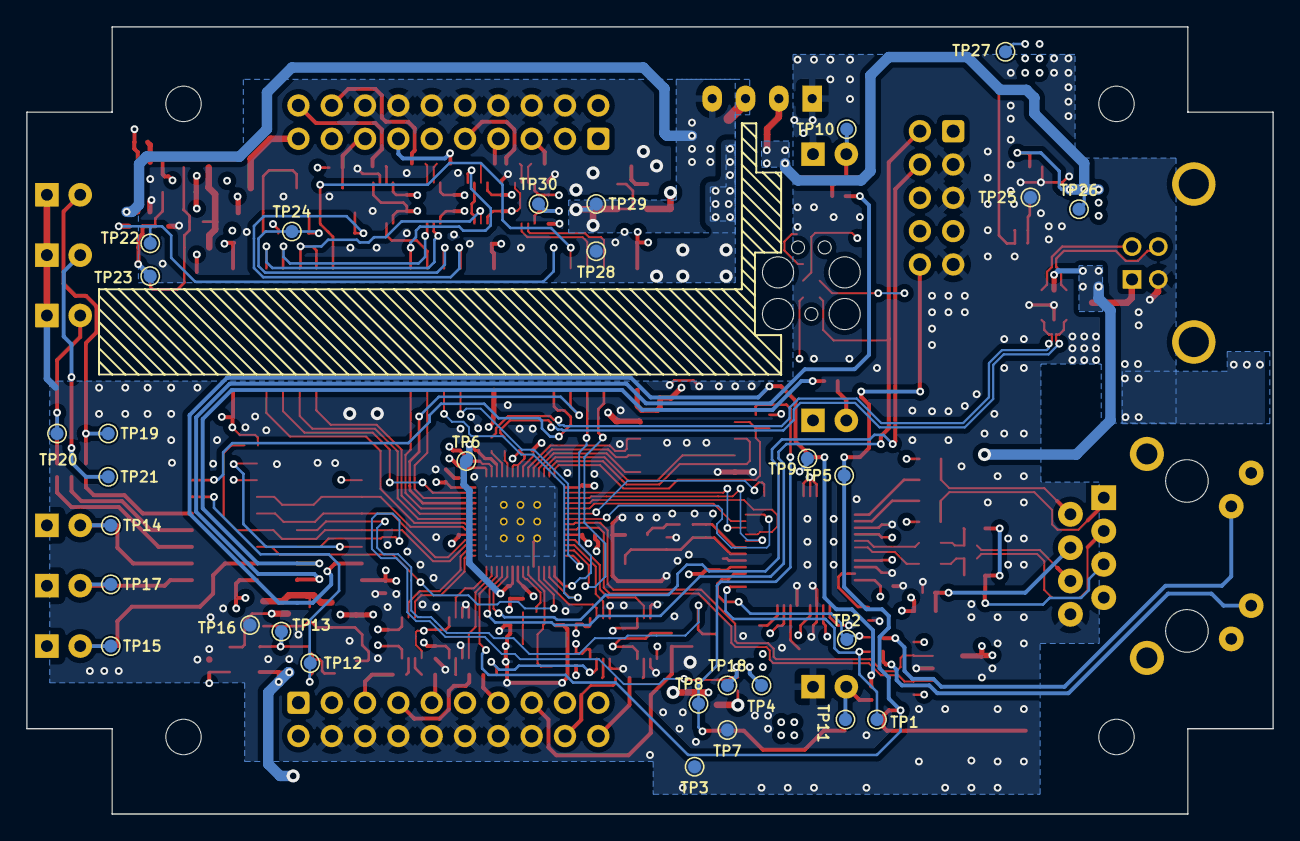
[picture p7: board RubyLink_revB.kicad_pcb from below]

Board: 4 copper layers, 95.0 x 60.0 mm, 219 parts (30 on the bottom side), 155 nets.

Other parts of the board:
REF1, REF2, REF3, REF4: MountingHole_2.7mm_M2.5
