Misaka0x2730/RubyLink/(commit log)

2021-08-15 Added schematic
    Added alpha-version of the schematic.
    Started PCB routing.
    [Input_interfaces.kicad_sch, MCU.kicad_sch, Power.kicad_sch, RubyLink_revA.kicad_pcb, RubyLink_revA.kicad_sch, Target1.kicad_sch, Target2_Iso.kicad_sch]
2021-08-18 Intermediate PCB routing results
    [Input_interfaces.kicad_sch, MCU.kicad_sch, Power.kicad_sch, RubyLink_revA.kicad_pcb, RubyLink_revA.kicad_sch, Target1.kicad_sch, Target2_Iso.kicad_sch]
2021-08-20 Pre-finished PCB version
    Pre-finished PCB version. Added 3D models for some components.
    [Input_interfaces.kicad_sch, MCU.kicad_sch, RubyLink_revA.kicad_pcb, RubyLink_revA.kicad_sch, Target1.kicad_sch, Target2_Iso.kicad_sch]
2021-08-21 Finished PCB routing
    [Input_interfaces.kicad_sch, MCU.kicad_sch, RubyLink_revA.kicad_pcb, RubyLink_revA.kicad_sch]
2021-10-10 Added final version and Gerber files.
    [Input_interfaces.kicad_sch, MCU.kicad_sch, Power.kicad_sch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]
2022-08-15 Added revision B
    Revision B:
    Replaced SMD LEDs by THT LEDs;
    Replaced USB Type C by USB-B;
    Optimized pinout to be able to control the isolated interface through the second PIO.
    Placed TC2030 footprint on the PCB.
    [Input_interfaces.kicad_sch, MCU.kicad_sch, Power.kicad_sch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]
